iorodeo/hallway_arenas/mechanics/dxf_version_v1p0/diffuser.pdf

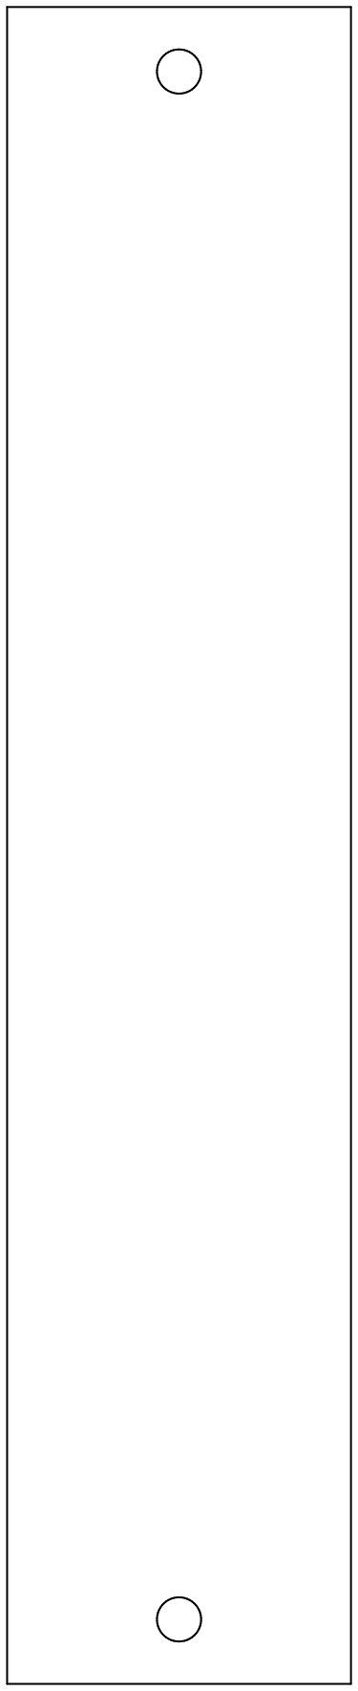
[picture p1: figure]

1 inch reference cube
