iorodeo/hallway_arenas/enclosures/nano_ssr_v1/laser_cutting_files_r1p0/enclosure_projection.dxf

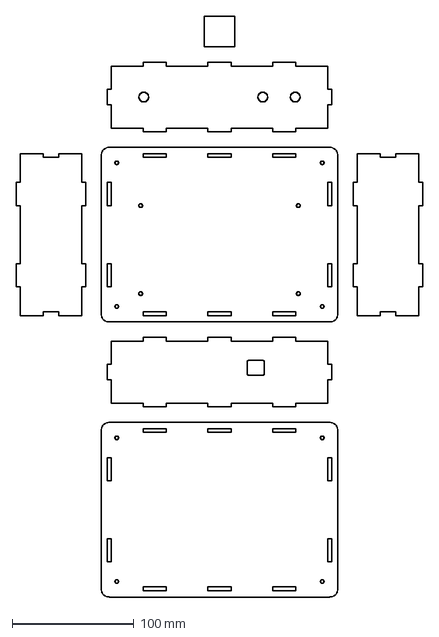
[picture p2: CAD file, 2011-09-14]
enclosures/nano_ssr_v1/laser_cutting_files_r1p0/enclosure_projection.dxf
334.0 x 477.5 mm
