iorodeo/hallway_arenas/mechanics/1010.dxf

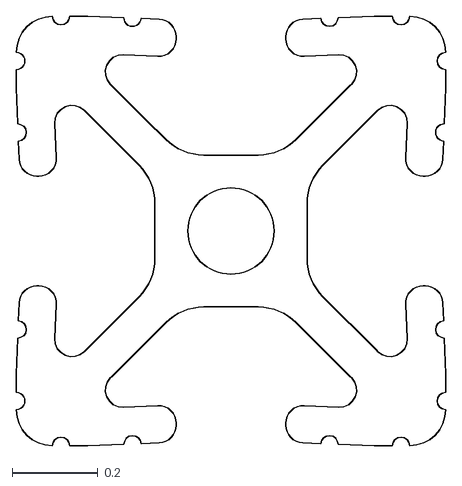
[picture p3: CAD file, 2011-07-21]
mechanics/1010.dxf
1.00 x 1.00
