iorodeo/hallway_arenas/mechanics/dxf_version_v1p0/camera_plate.dxf

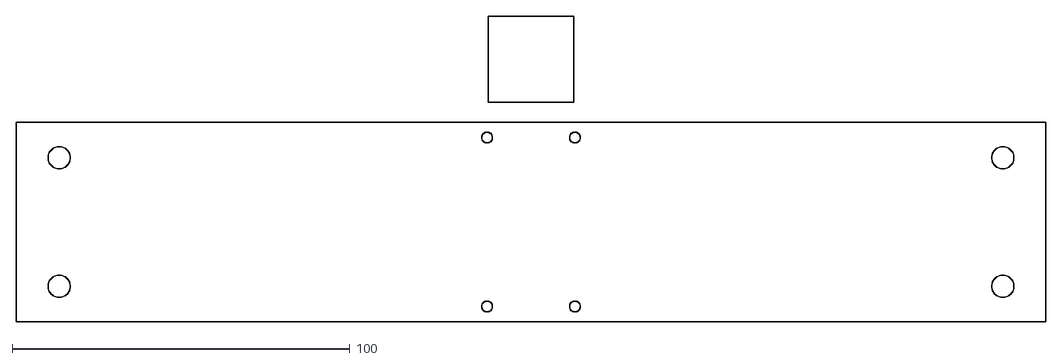
[picture p4: CAD file, 2011-08-16]
mechanics/dxf_version_v1p0/camera_plate.dxf
304.8 x 90.4
