iorodeo/hallway_arenas/(list of files, cad)

Other CAD files:
mechanics/dxf_version_v1p0/diffuser_in.dxf
mechanics/dxf_version_v1p0/diffuser.dxf
mechanics/dxf_version_v1p0/hallway_bottom_plate.dxf
mechanics/dxf_version_v1p0/hallway_top_plate.dxf
