iorodeo/hallway_arenas/enclosures/nano_ssr_v1/laser_cutting_files_r1p0/enclosure_projection.pdf

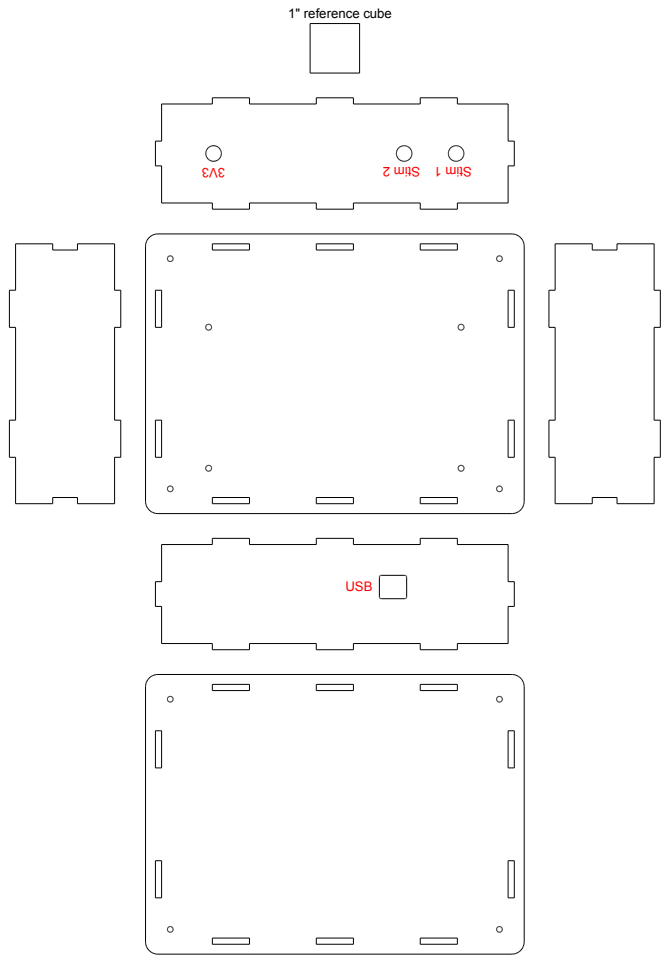
[picture p5: page 1]
USB; 1" reference cube
