iorodeo/hallway_arenas/(list of files, drawings)

Other design files:
panels_arena/hallway_panels_arena.dsn
