iorodeo/hallway_arenas/backlight/hallway_backlight.kicad_pcb

## KiCad design backlight/hallway_backlight.kicad_pcb (2020-04-21)

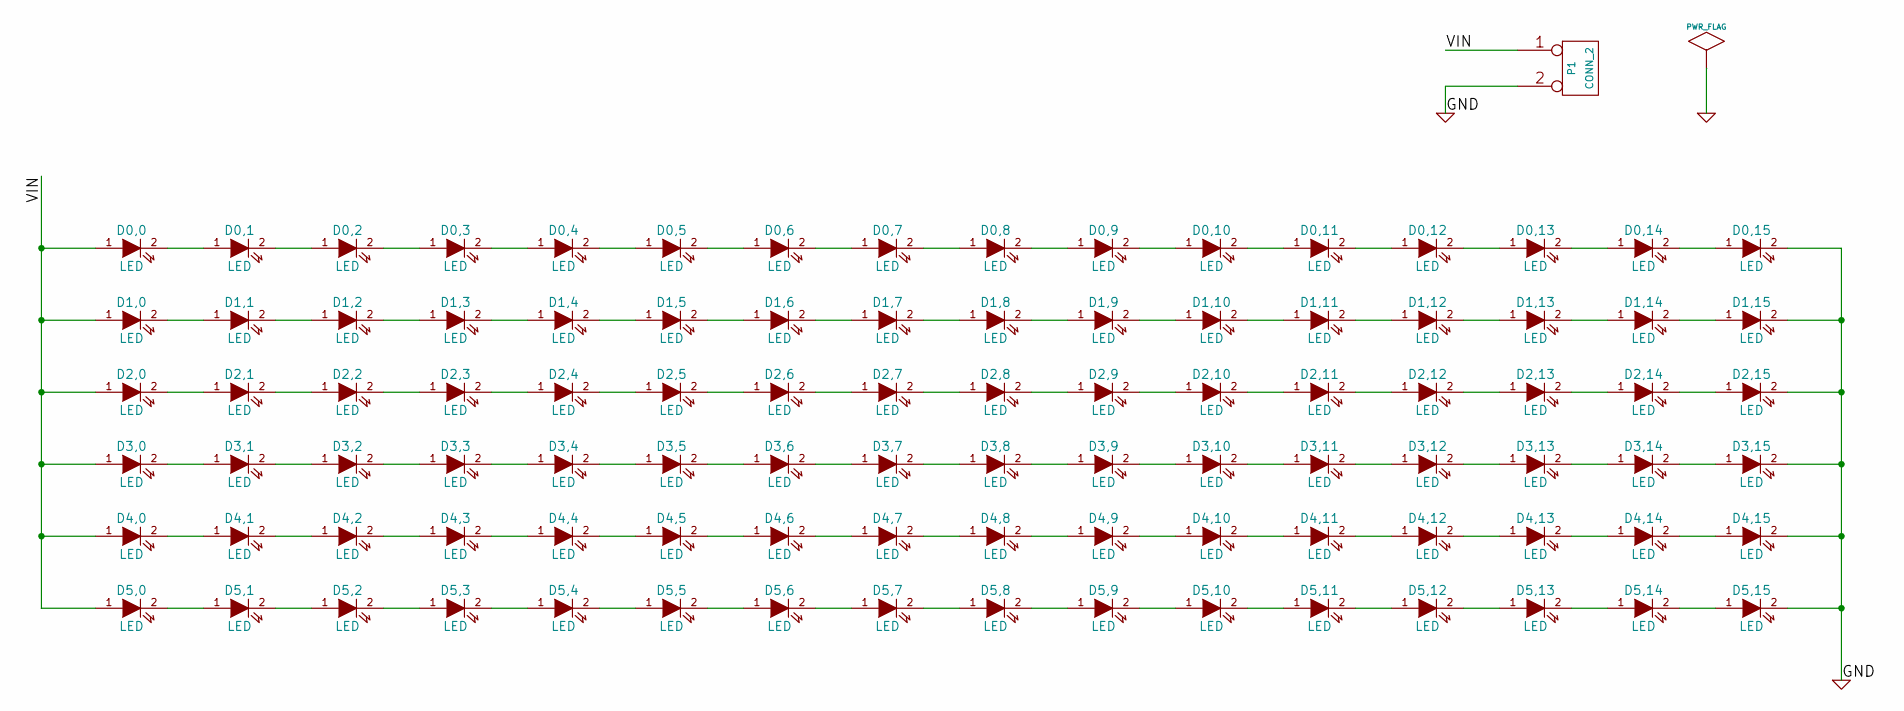
[picture p6: schematic hallway_backlight.sch]

Parts:
D0,0, D0,1, D0,2, D0,3, D0,4, D0,5, D0,6, D0,7, D0,8, D0,9, D0,10, D0,11, D0,12, D0,13, D0,14, D0,15, D1,0, D1,1, D1,2, D1,3, D1,4, D1,5, D1,6, D1,7, D1,8, D1,9, D1,10, D1,11, D1,12, D1,13, D1,14, D1,15, D2,0, D2,1, D2,2, D2,3, D2,4, D2,5, D2,6, D2,7, D2,8, D2,9, D2,10, D2,11, D2,12, D2,13, D2,14, D2,15, D3,0, D3,1, D3,2, D3,3, D3,4, D3,5, D3,6, D3,7, D3,8, D3,9, D3,10, D3,11, D3,12, D3,13, D3,14, D3,15, D4,0, D4,1, D4,2, D4,3, D4,4, D4,5, D4,6, D4,7, D4,8, D4,9, D4,10, D4,11, D4,12, D4,13, D4,14, D4,15, D5,0, D5,1, D5,2, D5,3, D5,4, D5,5, D5,6, D5,7, D5,8, D5,9, D5,10, D5,11, D5,12, D5,13, D5,14, D5,15: LED
P1: CONN_2

Connections:
/VIN: D0,0.1 (A), D1,0.1 (A), D2,0.1 (A), D3,0.1 (A), D4,0.1 (A), D5,0.1 (A), P1.1
GND: D0,15.2 (K), D1,15.2 (K), D2,15.2 (K), D3,15.2 (K), D4,15.2 (K), D5,15.2 (K), P1.2 (PM)
unnamed: D5,14.2 (K), D5,15.1 (A)
unnamed: D5,13.2 (K), D5,14.1 (A)
unnamed: D5,12.2 (K), D5,13.1 (A)
unnamed: D5,11.2 (K), D5,12.1 (A)
unnamed: D5,10.2 (K), D5,11.1 (A)
unnamed: D5,9.2 (K), D5,10.1 (A)
unnamed: D5,8.2 (K), D5,9.1 (A)
unnamed: D5,7.2 (K), D5,8.1 (A)
unnamed: D5,6.2 (K), D5,7.1 (A)
unnamed: D5,5.2 (K), D5,6.1 (A)
unnamed: D5,4.2 (K), D5,5.1 (A)
unnamed: D5,3.2 (K), D5,4.1 (A)
unnamed: D5,2.2 (K), D5,3.1 (A)
unnamed: D5,1.2 (K), D5,2.1 (A)
unnamed: D5,0.2 (K), D5,1.1 (A)
unnamed: D4,14.2 (K), D4,15.1 (A)
unnamed: D4,13.2 (K), D4,14.1 (A)
unnamed: D4,12.2 (K), D4,13.1 (A)
unnamed: D4,11.2 (K), D4,12.1 (A)
unnamed: D4,10.2 (K), D4,11.1 (A)
unnamed: D4,9.2 (K), D4,10.1 (A)
unnamed: D4,8.2 (K), D4,9.1 (A)
unnamed: D4,7.2 (K), D4,8.1 (A)
unnamed: D4,6.2 (K), D4,7.1 (A)
unnamed: D4,5.2 (K), D4,6.1 (A)
unnamed: D4,4.2 (K), D4,5.1 (A)
unnamed: D4,3.2 (K), D4,4.1 (A)
unnamed: D4,2.2 (K), D4,3.1 (A)
unnamed: D4,1.2 (K), D4,2.1 (A)
unnamed: D4,0.2 (K), D4,1.1 (A)
unnamed: D3,14.2 (K), D3,15.1 (A)
unnamed: D3,13.2 (K), D3,14.1 (A)
unnamed: D3,12.2 (K), D3,13.1 (A)
unnamed: D3,11.2 (K), D3,12.1 (A)
unnamed: D3,10.2 (K), D3,11.1 (A)
unnamed: D3,9.2 (K), D3,10.1 (A)
unnamed: D3,8.2 (K), D3,9.1 (A)
unnamed: D3,7.2 (K), D3,8.1 (A)
unnamed: D3,6.2 (K), D3,7.1 (A)
unnamed: D3,5.2 (K), D3,6.1 (A)
unnamed: D3,4.2 (K), D3,5.1 (A)
unnamed: D3,3.2 (K), D3,4.1 (A)
unnamed: D3,2.2 (K), D3,3.1 (A)
unnamed: D3,1.2 (K), D3,2.1 (A)
unnamed: D3,0.2 (K), D3,1.1 (A)
unnamed: D2,14.2 (K), D2,15.1 (A)
unnamed: D2,13.2 (K), D2,14.1 (A)
unnamed: D2,12.2 (K), D2,13.1 (A)
unnamed: D2,11.2 (K), D2,12.1 (A)
unnamed: D2,10.2 (K), D2,11.1 (A)
unnamed: D2,9.2 (K), D2,10.1 (A)
unnamed: D2,8.2 (K), D2,9.1 (A)
unnamed: D2,7.2 (K), D2,8.1 (A)
unnamed: D2,6.2 (K), D2,7.1 (A)
unnamed: D2,5.2 (K), D2,6.1 (A)
unnamed: D2,4.2 (K), D2,5.1 (A)
unnamed: D2,3.2 (K), D2,4.1 (A)
unnamed: D2,2.2 (K), D2,3.1 (A)
unnamed: D2,1.2 (K), D2,2.1 (A)
unnamed: D2,0.2 (K), D2,1.1 (A)
unnamed: D1,14.2 (K), D1,15.1 (A)
unnamed: D1,13.2 (K), D1,14.1 (A)
unnamed: D1,12.2 (K), D1,13.1 (A)
unnamed: D1,11.2 (K), D1,12.1 (A)
unnamed: D1,10.2 (K), D1,11.1 (A)
unnamed: D1,9.2 (K), D1,10.1 (A)
unnamed: D1,8.2 (K), D1,9.1 (A)
unnamed: D1,7.2 (K), D1,8.1 (A)
unnamed: D1,6.2 (K), D1,7.1 (A)
unnamed: D1,5.2 (K), D1,6.1 (A)
unnamed: D1,4.2 (K), D1,5.1 (A)
unnamed: D1,3.2 (K), D1,4.1 (A)
unnamed: D1,2.2 (K), D1,3.1 (A)
unnamed: D1,1.2 (K), D1,2.1 (A)
unnamed: D1,0.2 (K), D1,1.1 (A)
unnamed: D0,14.2 (K), D0,15.1 (A)
unnamed: D0,13.2 (K), D0,14.1 (A)
unnamed: D0,12.2 (K), D0,13.1 (A)
unnamed: D0,11.2 (K), D0,12.1 (A)
unnamed: D0,10.2 (K), D0,11.1 (A)
unnamed: D0,9.2 (K), D0,10.1 (A)
unnamed: D0,8.2 (K), D0,9.1 (A)
unnamed: D0,7.2 (K), D0,8.1 (A)
unnamed: D0,6.2 (K), D0,7.1 (A)
unnamed: D0,5.2 (K), D0,6.1 (A)
unnamed: D0,4.2 (K), D0,5.1 (A)
unnamed: D0,3.2 (K), D0,4.1 (A)
unnamed: D0,2.2 (K), D0,3.1 (A)
unnamed: D0,1.2 (K), D0,2.1 (A)
unnamed: D0,0.2 (K), D0,1.1 (A)

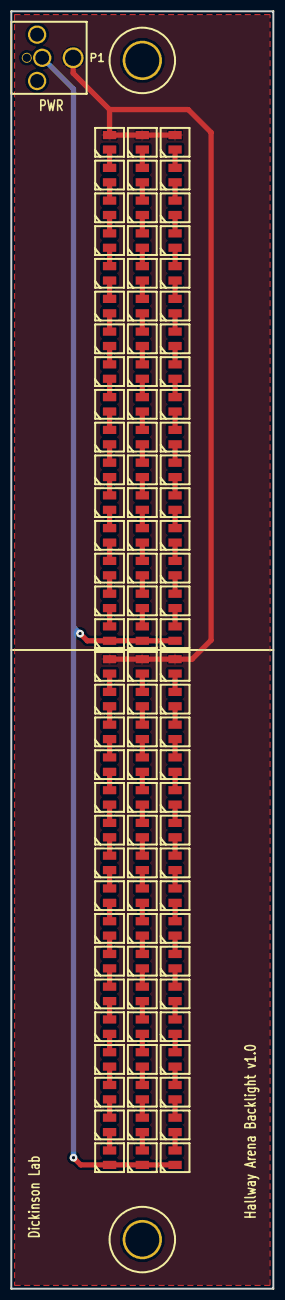
[picture p7: board hallway_backlight.kicad_pcb from above]

Board: 2 copper layers, 50.8 x 247.6 mm, 99 parts (0 on the bottom side), 92 nets.

Other parts of the board:
1/4-20, 1/4-20#2: VAL**; 1%2f4-20
