iorodeo/hallway_arenas/panels_arena/hallway_panels_arena.kicad_pcb

## KiCad design panels_arena/hallway_panels_arena.kicad_pcb (2020-04-21)

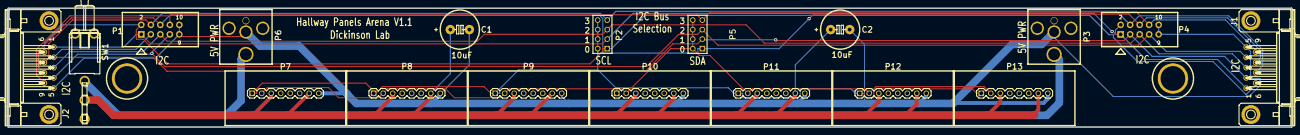
[picture p8: board hallway_panels_arena.kicad_pcb from above]

Board: 2 copper layers, 342.9 x 31.8 mm, 20 parts (0 on the bottom side), 13 nets.

Parts:
1/4-20,1, 1/4-20,2: VAL**; 1%2f4-20
C1, C2: 10uF; JFRC_Capacitor_Polarized
J1, J2: DB9; DB9_M09
P1, P4: CONN_5X2; HEADER_5x2_LARGE
P2, P5: CONN_4X2; pin_array_4x2
P3, P6: CONN_2; DCJACK_2PIN_HIGHCURRENT
P7, P8, P9, P10, P11, P12, P13: CONN_8; JFRC_1X08
SW1: SWITCH_INV; JFRC_LPV-1

Connections:
/5V: C1.1, C2.1, P7.3, P7.7, P8.3, P8.7, P9.3, P9.7, P10.3, P10.7, P11.3, P11.7, P12.3, P12.7, P13.3, P13.7, SW1.2
/SCL: P2.2, P2.4, P2.6, P2.8, P7.1, P8.1, P9.1, P10.1, P11.1, P12.1, P13.1
/SCL0: J1.6, J2.6, P1.2, P2.1, P4.2
/SCL1: J1.1, J2.1, P1.1, P2.3, P4.1
/SCL2: J1.3, J2.3, P1.5, P2.5, P4.5
/SCL3: J1.7, J2.7, P1.4, P2.7, P4.4
/SDA: P5.2, P5.4, P5.6, P5.8, P7.2, P8.2, P9.2, P10.2, P11.2, P12.2, P13.2
/SDA0: J1.8, J2.8, P1.6, P4.6, P5.1
/SDA1: J1.2, J2.2, P1.3, P4.3, P5.3
/SDA2: J1.4, J2.4, P1.7, P4.7, P5.5
/SDA3: J1.9, J2.9, P1.8, P4.8, P5.7
GND: C1.2, C2.2, J1.5, J2.5, P1.9, P1.10, P3.2, P4.9, P4.10, P6.2, P7.8, P8.8, P9.8, P10.8, P11.8, P12.8, P13.8
unnamed: P3.1, P6.1, SW1.1
