iorodeo/hallway_arenas/panels_arena/hallway_panels_arena.sch

## KiCad design panels_arena/hallway_panels_arena.sch (2020-04-21, an earlier design)

Schematic: hallway_panels_arena.sch

Parts:
C1, C2: 10uF
J1, J2: DB9
P1, P4: CONN_5X2
P2, P5: CONN_4X2
P3, P6: CONN_2
P7, P8, P9, P10, P11, P12, P13: CONN_8
SW1: SWITCH_INV

Notes on the sheet:
PANELS
5V POWER INPUTS
I2C CONNECTORS
SDA
SCL
BUS SELECTION JUMPERS
