iorodeo/hallway_arenas/(commit log)

2011-07-05 Added panels, panels pcb, headers. Modified assembly class so that translations and rotations are applied to individual objects.
2011-07-05 Modified assembly files and part class so that rotations, translations and color commands are handled differently.
2011-07-05 Added stl file creation for system assembly.
2011-07-06 Added vconfig creation for stl file version of assemblies.
2011-07-20 Add breadboard model, build script. Modified backlight standoffs so that they are on vibration grommets. Modofied Standoff_Grommet_Assembly so that the name of the standoff parameters can be specifie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
    [backlight_assembly.py, breadboard.py, build.py, hallway_assembly.py, panels_assembly.py, panels_pcb_assembly.py, params.py, standoff_grommet_assembly.py]
2011-07-21 Added two arena assembly and pager motor holder.
2011-07-21 Removed cutouts for pager motors. Added pager motor holders to arena assemblies.
2011-07-21 Added camera posts, camera plate, camera model.
    [1010.dxf]
2011-07-22 Added bracket and stl creation file for breadboard (because it takes a long time). Moved stl create to the Part class.
2011-07-25 Uncommented breadboard holes.
2011-07-25 Put mechanical design in directory named "mechanics".
    [1010.dxf]
2011-07-26 Finished design of backlight pcb.
    [$savepcb.brd, hallway_backlight.brd, hallway_backlight.sch]
2011-07-27 Finished hallway panels arena design. Still need to add annotation to the board.
    [$savepcb.brd, hallway_backlight.brd, hallway_panels_arena.brd, hallway_panels_arena.sch]
2011-08-10 Finished initial design.
    [$savepcb.brd, hallway_backlight.brd, hallway_backlight.sch, hallway_panels_arena.brd]
2011-08-10 Added version 1 of the gerber file for the linear arena and the backlight. These are the versions ordered from PCB manufacturer.
    [hallway_backlight-Component.gtl, hallway_backlight-Copper.gbl, hallway_backlight-Mask_Back.gbs, hallway_backlight-Mask_Front.gts, hallway_backlight-PCB_Edges.gbr, hallway_backlight-SilkS_Back.gbo, hallway_backlight-SilkS_Front.gto, hallway_backlight.drl]
2011-08-11 Worked on bill-of-material for mechanics. Resized some of the standoffs due to availability.
2011-08-11 Worked some more on bill of materials.
2011-08-16 Added BOMs.
    [hallway_bottom_plate.dxf]
2011-08-16 Created version 1.0 version of dxf files for laser cutting.
    [diffuser.dxf, hallway_bottom_plate.dxf, hallway_top_plate.dxf]
2011-08-16 Added dxf
    Added camera plate dxf file.
    [camera_plate.dxf]
2011-09-14 Created enclosure for nano solid state relay board.
    [enclosure_projection.dxf]
2015-05-28 Added in version of diffuser dxf.
    [diffuser_in.dxf]
2020-04-21 Upgraded hallway arena for kicad 4
    [hallway_panels_arena-2020-04-20-17-16-24.sch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]
2020-04-21 update backligh for kicad 4.
    [hallway_backlight-2020-04-20-17-59-32.sch, hallway_backlight.sch]
2020-04-21 Added a version of PCBs with Dickinson Lab on them instead of IO Rodeo.
    [hallway_backlight-B.Mask.gbs, hallway_backlight-B.SilkS.gbo, hallway_backlight-Component.gtl, hallway_backlight-Copper.gbl, hallway_backlight-Edge.Cuts.gm1, hallway_backlight-F.Mask.gts, hallway_backlight-F.SilkS.gto, hallway_backlight-Mask_Back.gbs]
